davidjmoloney/FYP_Files/Spoon-solidworks.JPG

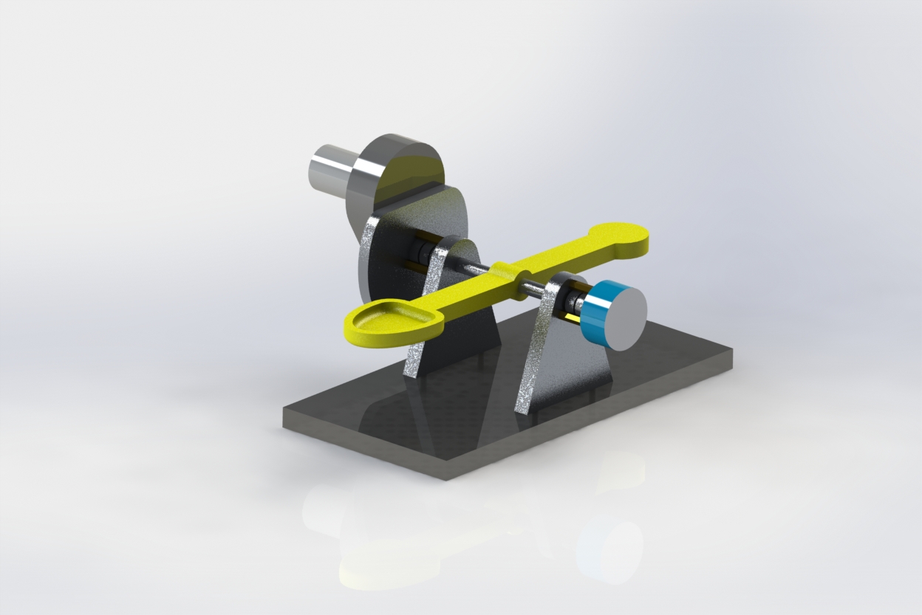
Spoon-solidworks.JPG
