davidjmoloney/FYP_Files/IMG_20200213_154914.jpg

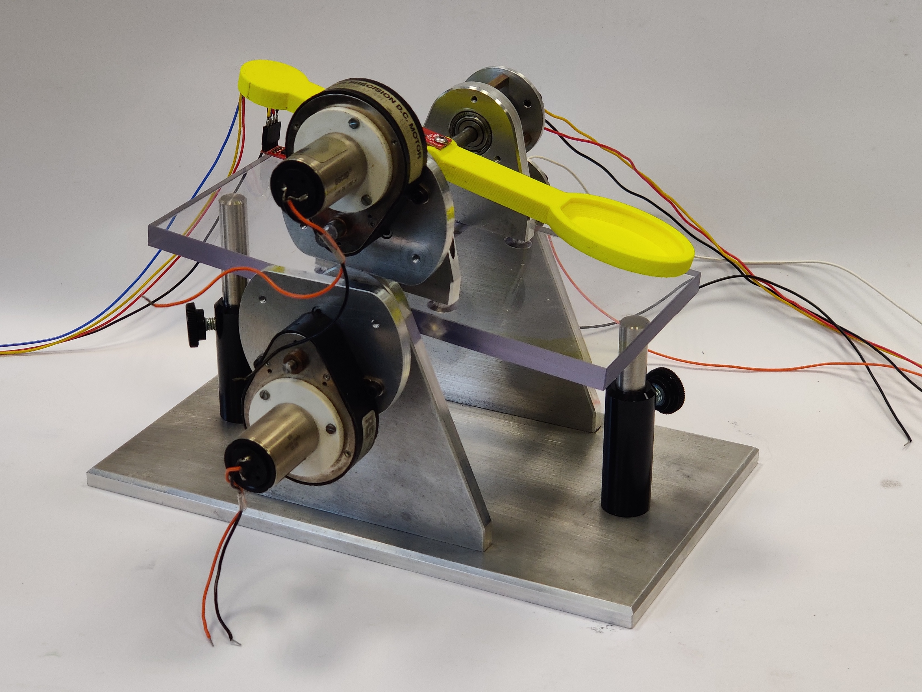
IMG_20200213_154914.jpg
