davidjmoloney/FYP_Files/README.md

# FYP_Files
A repository containing the most important files created/used during the course of my Final Year Project
